Ball-On-Plate/Ball-on-Plate/Ball_on_Plate/Linux_3DModule/basketTexture.jpg

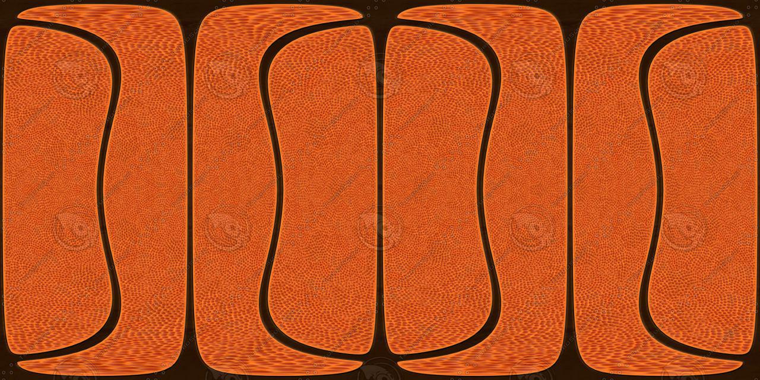
Ball_on_Plate/Linux_3DModule/basketTexture.jpg
