Ball-On-Plate/Ball-on-Plate/Ball_on_Plate/Linux_3DModule/ball.obj

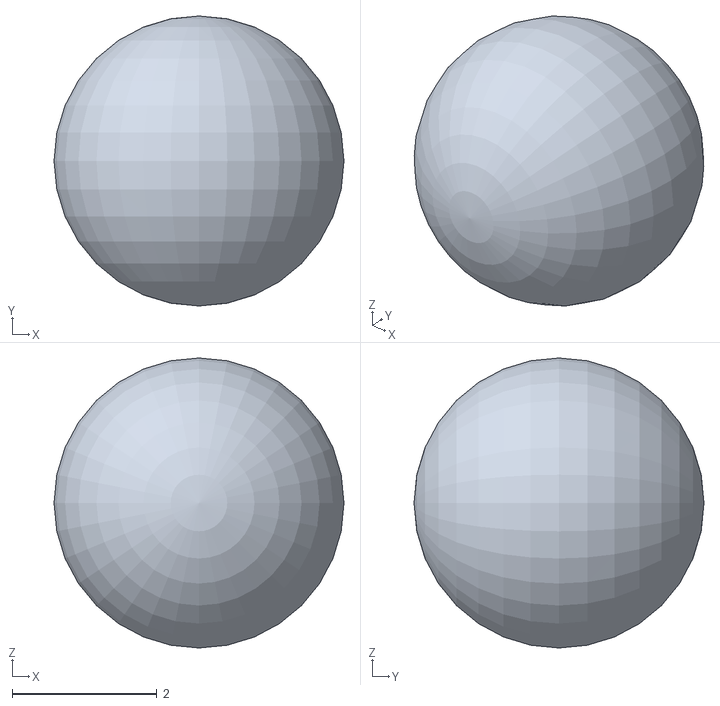
[picture p20: CAD file, 2017-09-28]
Ball_on_Plate/Linux_3DModule/ball.obj
4.00 x 4.00 x 4.00
