Ball-On-Plate/Ball-on-Plate/Ball_on_Plate/Linux_3DModule/yildizX.obj

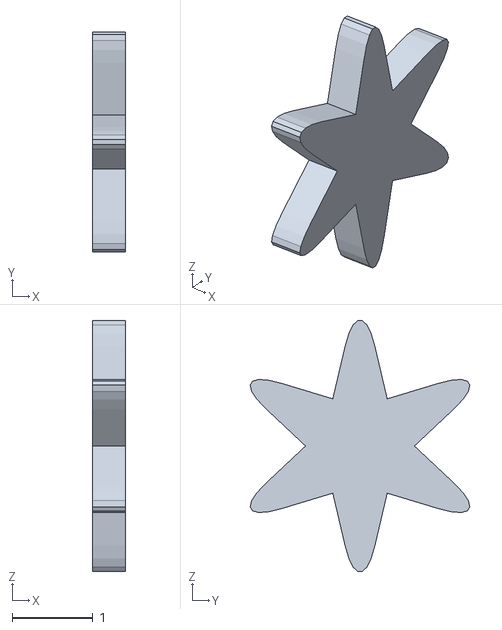
[picture p21: CAD file, 2017-09-28]
Ball_on_Plate/Linux_3DModule/yildizX.obj
0.403 x 2.71 x 3.10
