Ball-On-Plate/Ball-on-Plate/Ball_on_Plate/Linux_3DModule/cubuk.obj

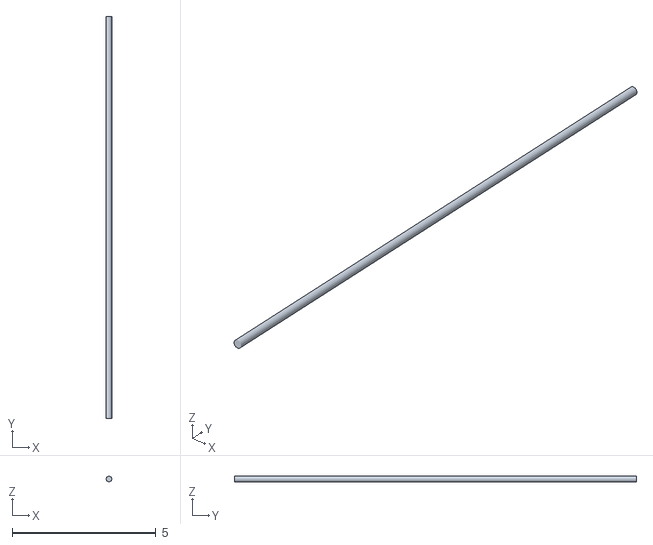
[picture p22: CAD file, 2017-09-28]
Ball_on_Plate/Linux_3DModule/cubuk.obj
0.2 x 14.0 x 0.197
