Ball-On-Plate/Ball-on-Plate/Ball_on_Plate/Linux_3DModule/altTahta.obj

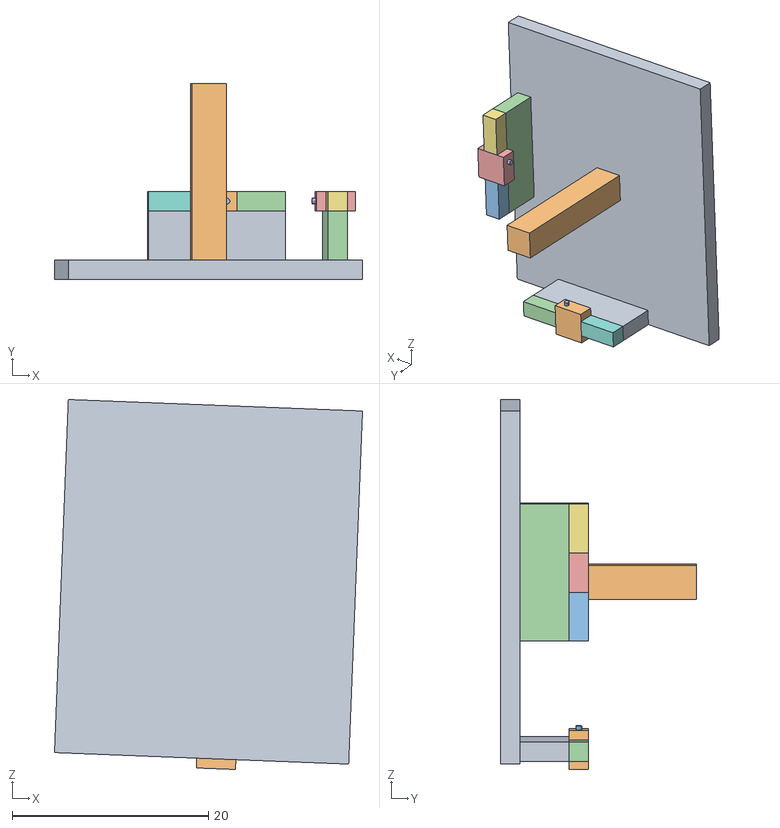
[picture p23: CAD file, 2017-09-28]
Ball_on_Plate/Linux_3DModule/altTahta.obj
31.4 x 20.0 x 37.7
