Ball-On-Plate/Ball-on-Plate/Ball_on_Plate/Linux_3DModule/ustTahta.obj

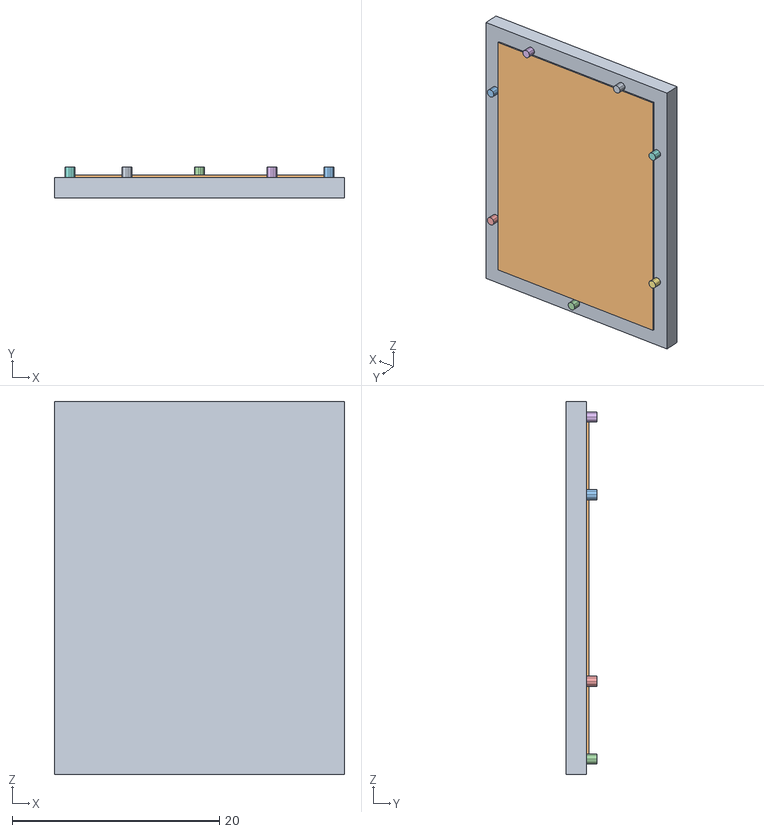
[picture p24: CAD file, 2017-09-28]
Ball_on_Plate/Linux_3DModule/ustTahta.obj
28.0 x 3.00 x 36.0
