Ball-On-Plate/Ball-on-Plate/Ball_on_Plate/Linux_3DModule/isik.obj

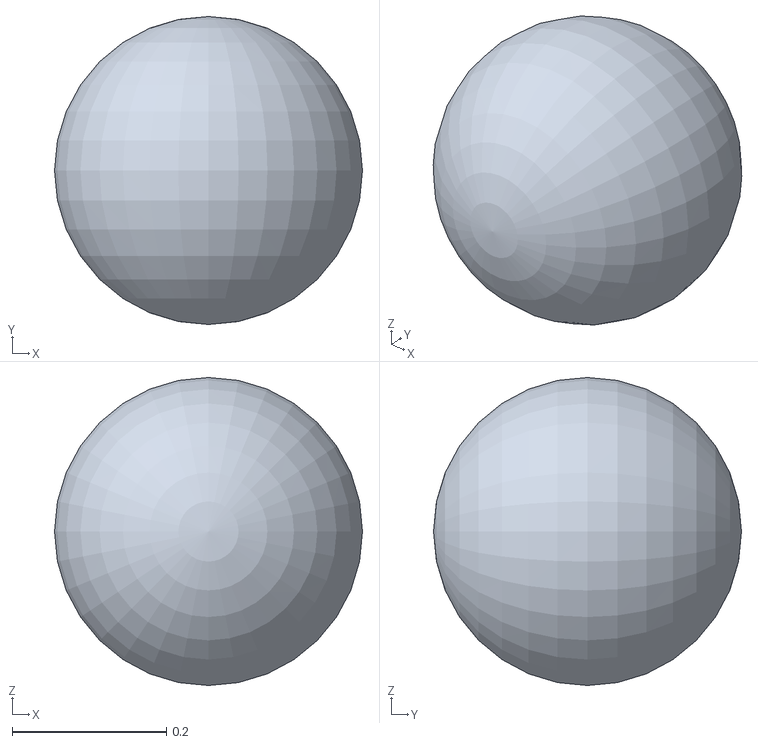
[picture p25: CAD file, 2017-09-28]
Ball_on_Plate/Linux_3DModule/isik.obj
0.4 x 0.4 x 0.4
