Ball-On-Plate/Ball-on-Plate/Ball_on_Plate/Linux_3DModule/box.obj

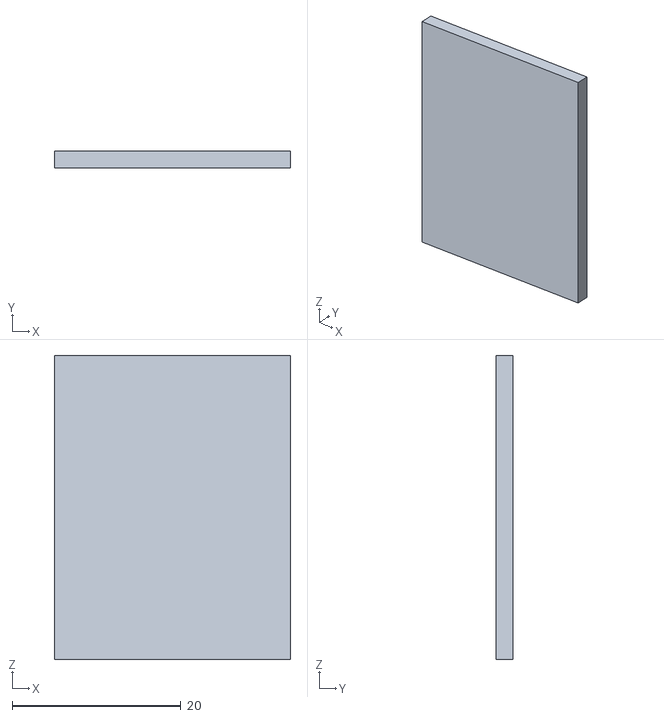
[picture p26: CAD file, 2017-09-28]
Ball_on_Plate/Linux_3DModule/box.obj
28.0 x 2.00 x 36.0
