Ball-On-Plate/Ball-on-Plate/(list of files, cad)

Other CAD files:
Ball_on_Plate/Linux_3DModule/yildiz.obj
