Ball-On-Plate/Ball-on-Plate/(notices)

Notices in the files:
Ball_on_Plate/Linux_3DModule/Codes/rs232.cpp:
This program is free software: you can redistribute it and/or modify
it under the terms of the GNU General Public License as published by
the Free Software Foundation, either version 3 of the License, or
(at your option) any later version.
Ball_on_Plate/Linux_3DModule/yildizX.obj:
3ds Max Wavefront OBJ Exporter v0.97b - (c)2007 guruware
